LouisSR/TempRFin/feather_fabprint M0.png

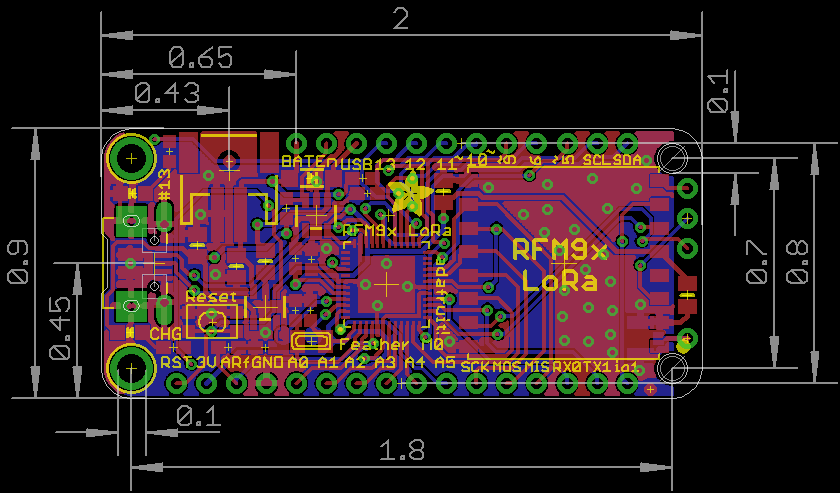
feather_fabprint M0.png
