LouisSR/TempRFin/PCB/TempRFIn Layout.png

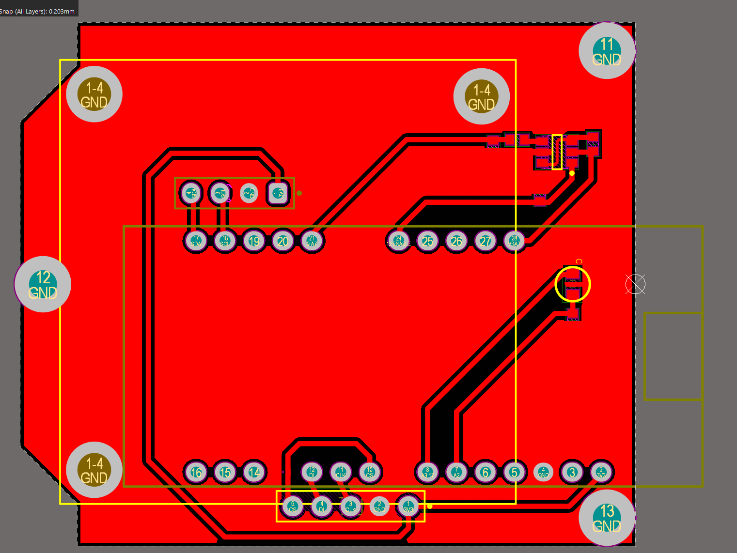
PCB/TempRFIn Layout.png
