LouisSR/TempRFin/TempIn Dark Sleep 14uA.png

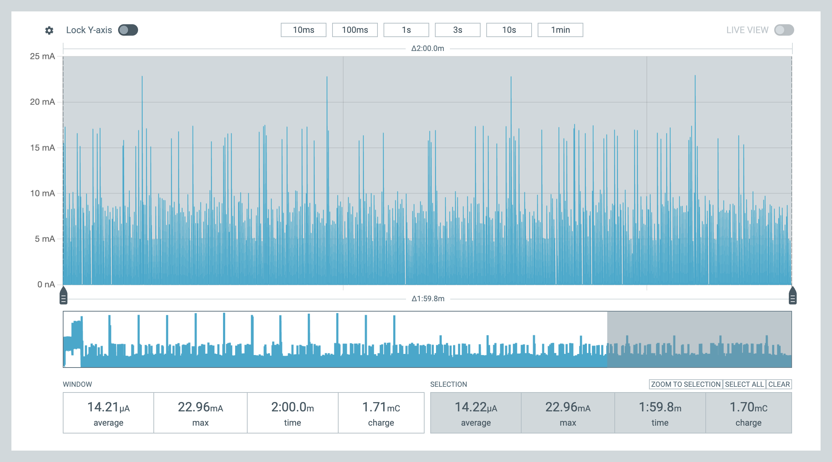
TempIn Dark Sleep 14uA.png
