LouisSR/TempRFin/TempIn On 191ms.png

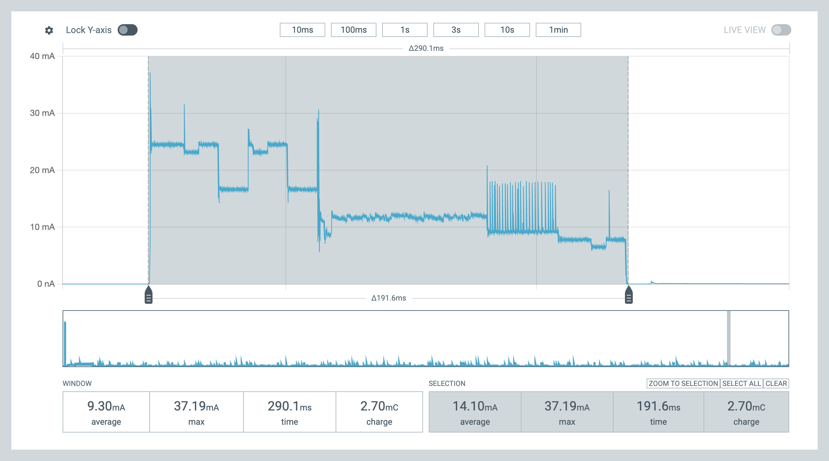
TempIn On 191ms.png
