LouisSR/TempRFin/TempIn Sleep 18s.png

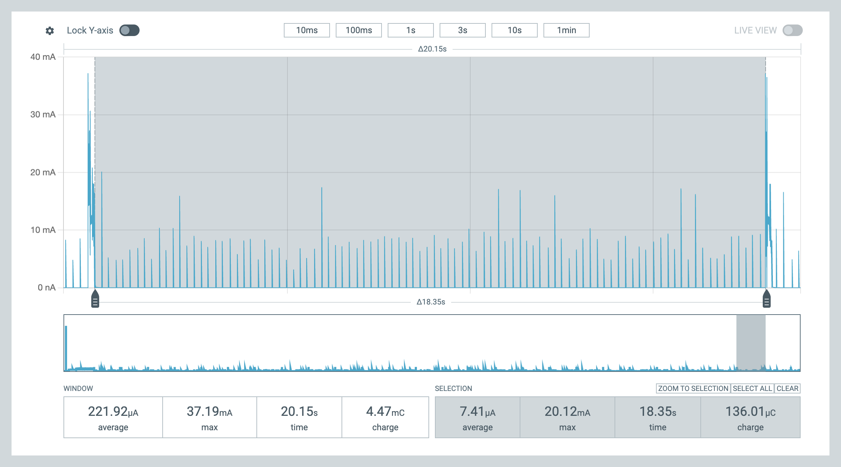
TempIn Sleep 18s.png
