LouisSR/TempRFin/TempIn Sync 20mA.png

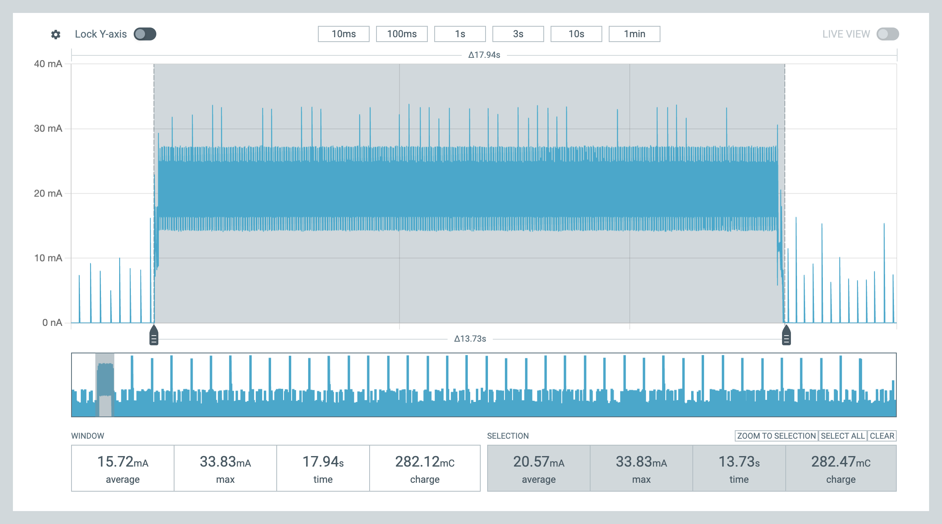
TempIn Sync 20mA.png
