LouisSR/TempRFin/PCB/TempRFIn Schematics.pdf

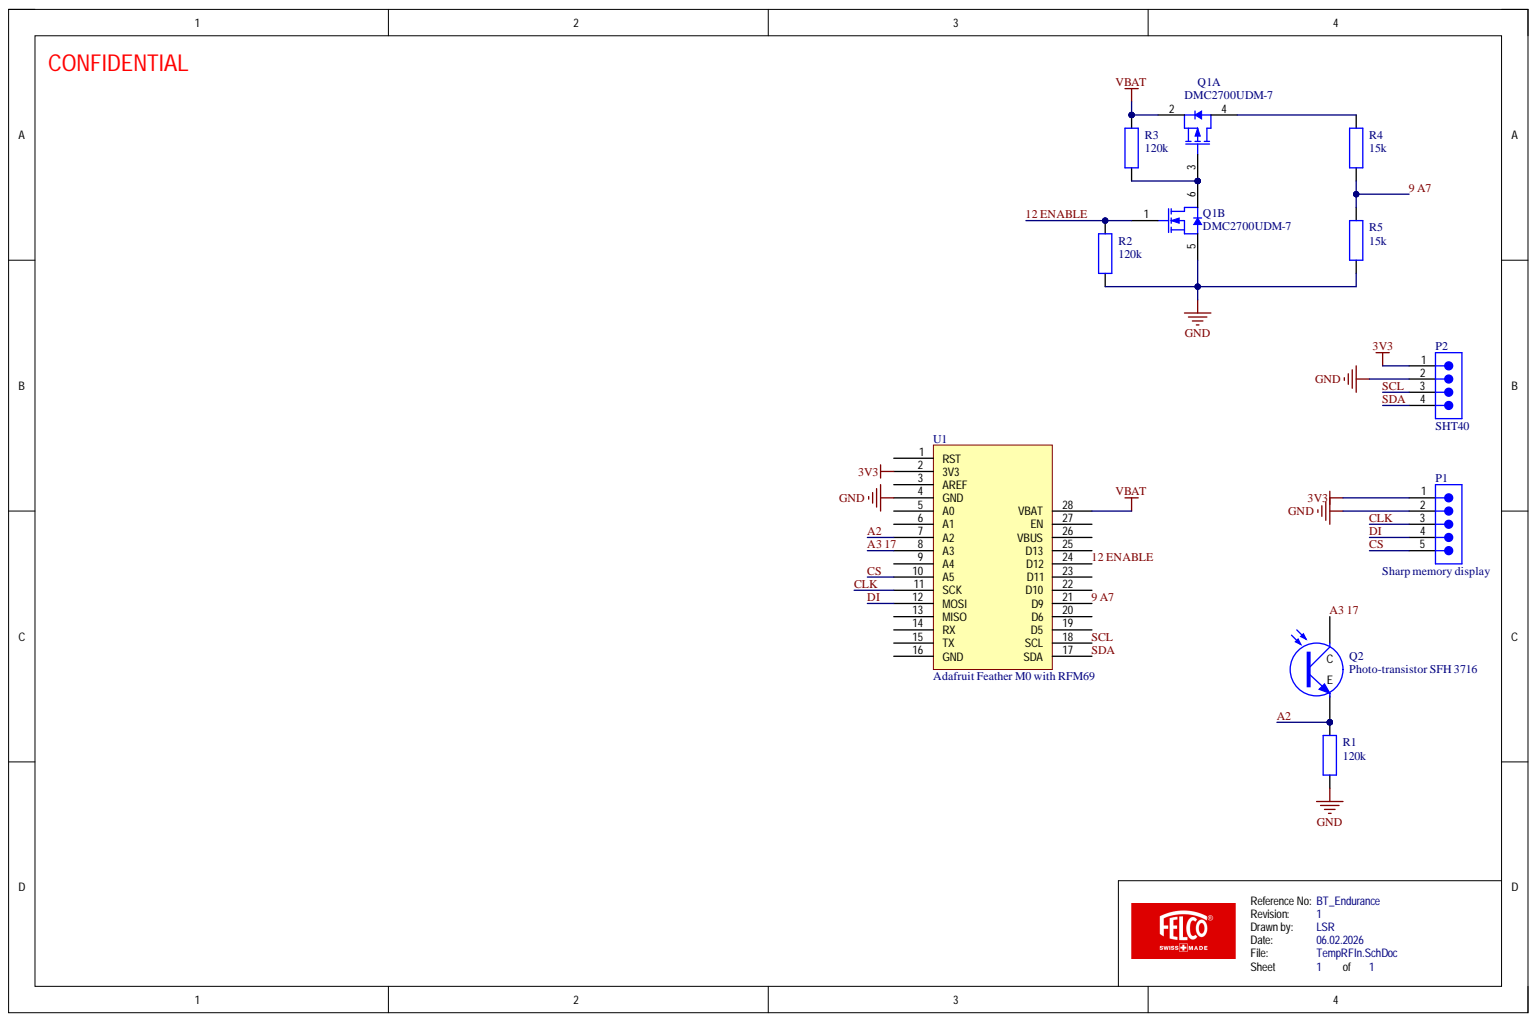
[picture p7: page 1]
