LouisSR/TempRFin/(list of files, drawings)

Other design files:
PCB/TempRFIn.PcbDoc
PCB/TempRFIn.PrjPcb
PCB/TempRFIn.SchDoc
