LouisSR/TempRFin/TempIn Dark Luminosity measurement.png

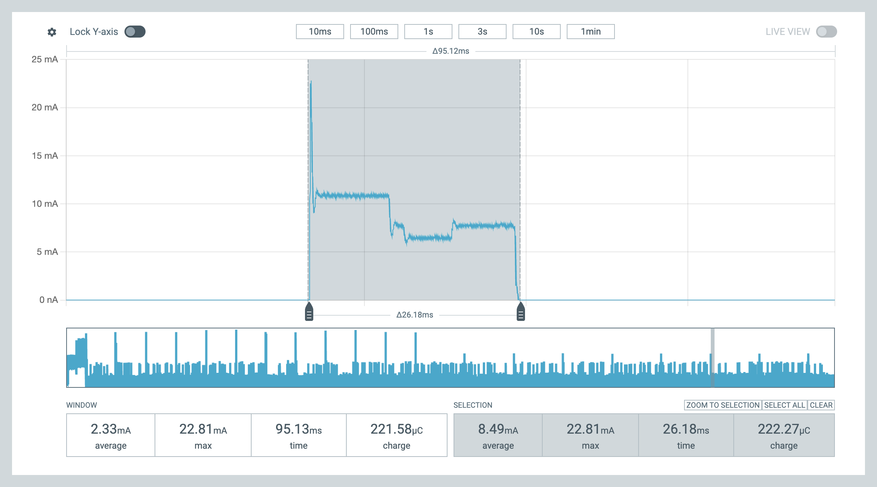
TempIn Dark Luminosity measurement.png
