LouisSR/TempRFin/(commit log)

2026-04-25 Create display.h for graphic management. Bigger battery symbol
2026-05-03 Add luminosity management ; Sleep for 18s
    [TempRFIn.PcbDoc, TempRFIn.PrjPcb, TempRFIn.SchDoc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]
